SoftwareCornwall/Mission-to-Mars-Rover/Datasheets/Chassis/HTB1ze.hXRGw3KVjSZFwq6zQ2FXaO.jpg_.webp

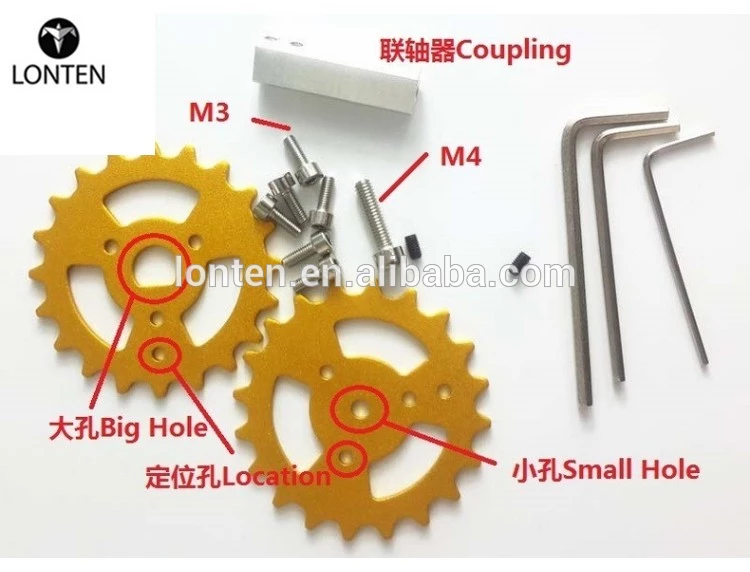
Datasheets/Chassis/HTB1ze.hXRGw3KVjSZFwq6zQ2FXaO.jpg_.webp
