SoftwareCornwall/Mission-to-Mars-Rover/Datasheets/Chassis/HTB11pEdXRWD3KVjSZFsq6AqkpXaN.jpg_.webp

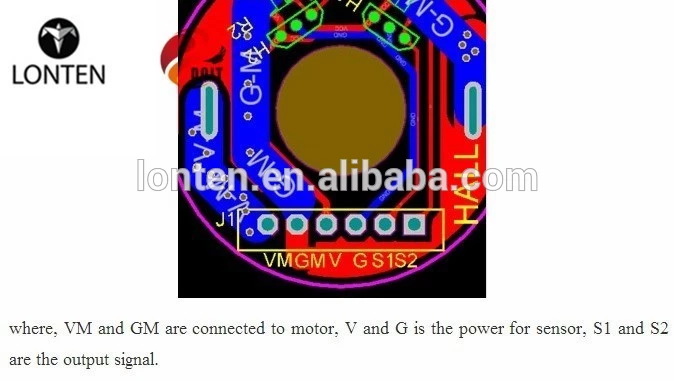
Datasheets/Chassis/HTB11pEdXRWD3KVjSZFsq6AqkpXaN.jpg_.webp
