SoftwareCornwall/Mission-to-Mars-Rover/Datasheets/Chassis/HTB1_V7cXQ9E3KVjSZFGq6A19XXaw.jpg_.webp

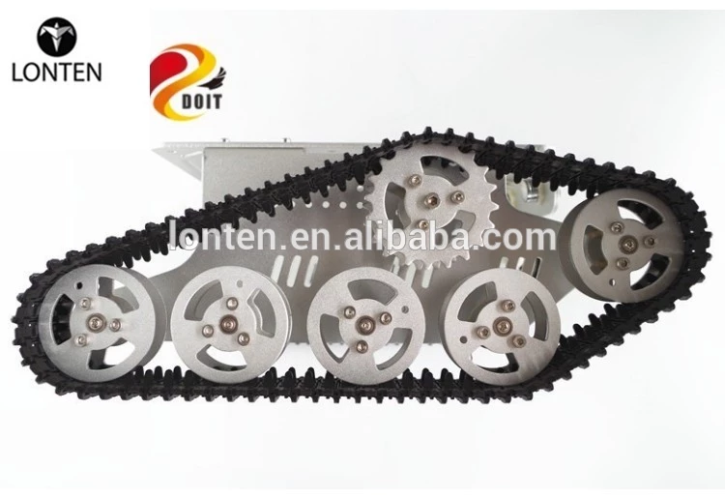
Datasheets/Chassis/HTB1_V7cXQ9E3KVjSZFGq6A19XXaw.jpg_.webp
