SoftwareCornwall/Mission-to-Mars-Rover/Datasheets/Chassis/HTB1b0IbXLWG3KVjSZPcq6zkbXXat.jpg_.webp

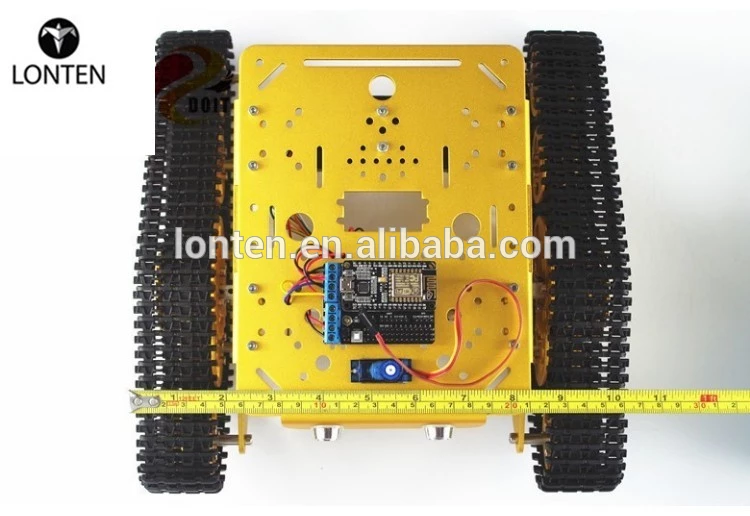
Datasheets/Chassis/HTB1b0IbXLWG3KVjSZPcq6zkbXXat.jpg_.webp
