SoftwareCornwall/Mission-to-Mars-Rover/Datasheets/Chassis/HTB1G.kcXR1D3KVjSZFyq6zuFpXam.jpg_.webp

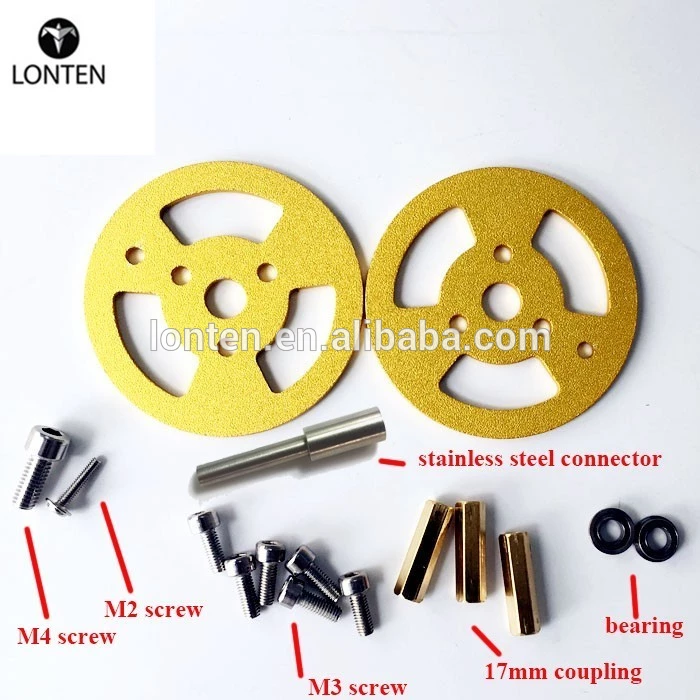
Datasheets/Chassis/HTB1G.kcXR1D3KVjSZFyq6zuFpXam.jpg_.webp
