SoftwareCornwall/Mission-to-Mars-Rover/Datasheets/Chassis/HTB1LNwaXMaH3KVjSZFpq6zhKpXaN.jpg_.webp

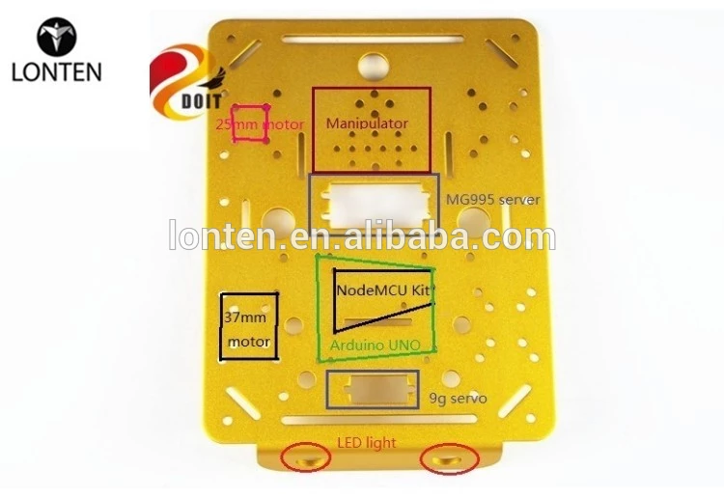
Datasheets/Chassis/HTB1LNwaXMaH3KVjSZFpq6zhKpXaN.jpg_.webp
