SoftwareCornwall/Mission-to-Mars-Rover/Datasheets/Chassis/HTB1T0UkXHus3KVjSZKbq6xqkFXaN.jpg_.webp

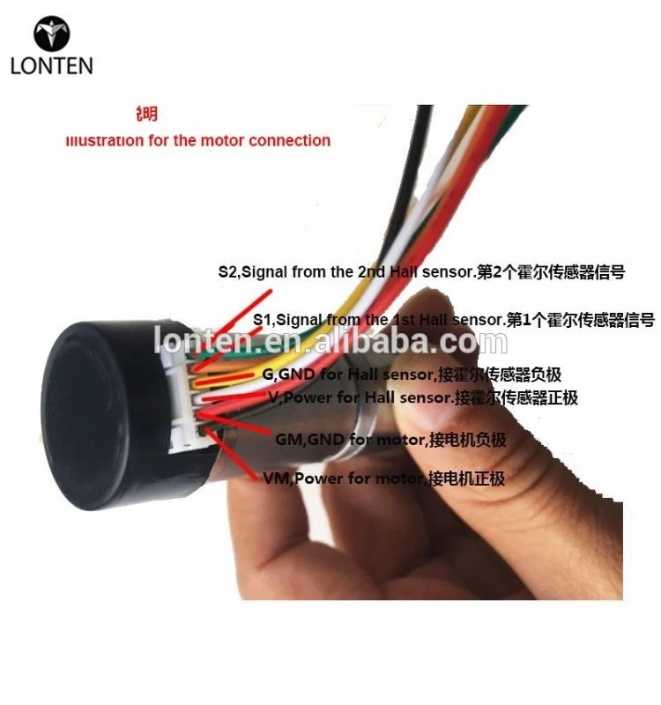
Datasheets/Chassis/HTB1T0UkXHus3KVjSZKbq6xqkFXaN.jpg_.webp
