SoftwareCornwall/Mission-to-Mars-Rover/Datasheets/Chassis/HTB1VvZbXUGF3KVjSZFmq6zqPXXaq.jpg_.webp

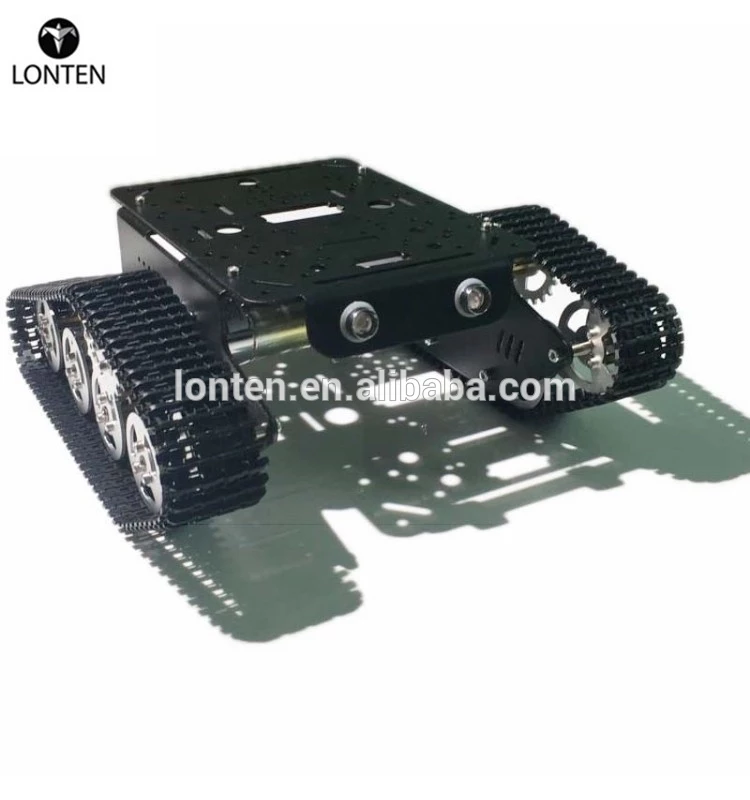
Datasheets/Chassis/HTB1VvZbXUGF3KVjSZFmq6zqPXXaq.jpg_.webp
