SoftwareCornwall/Mission-to-Mars-Rover/Handouts/Rover PCB as Breadboard_bb.png

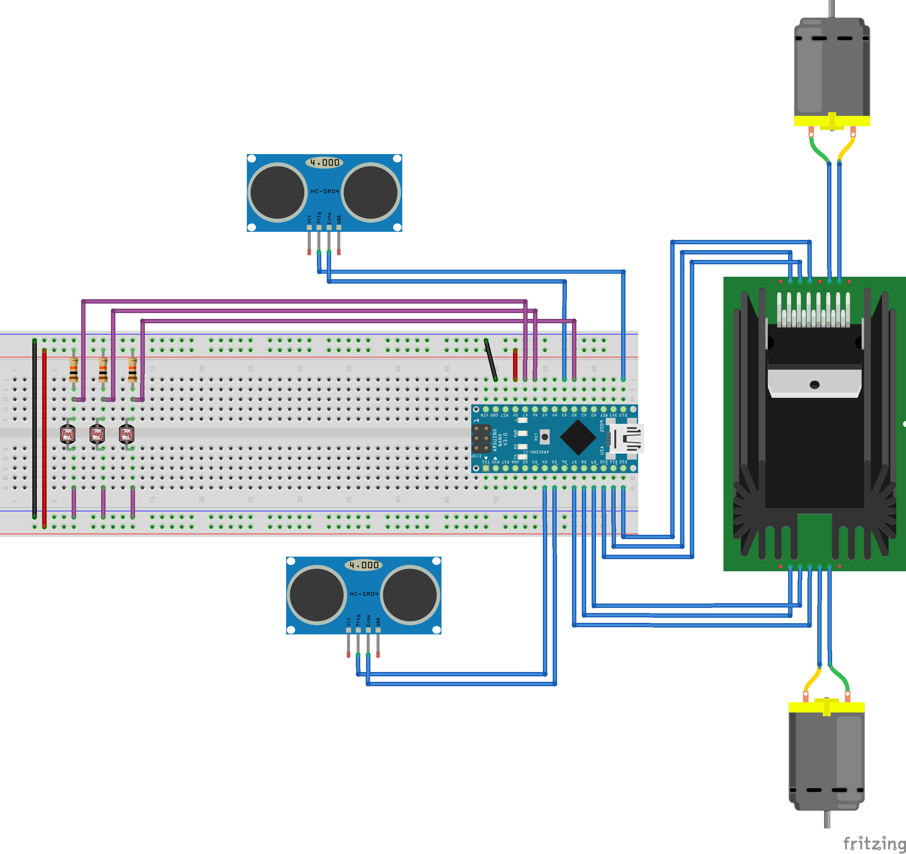
Handouts/Rover PCB as Breadboard_bb.png
