SoftwareCornwall/Mission-to-Mars-Rover/Handouts/Rover.png

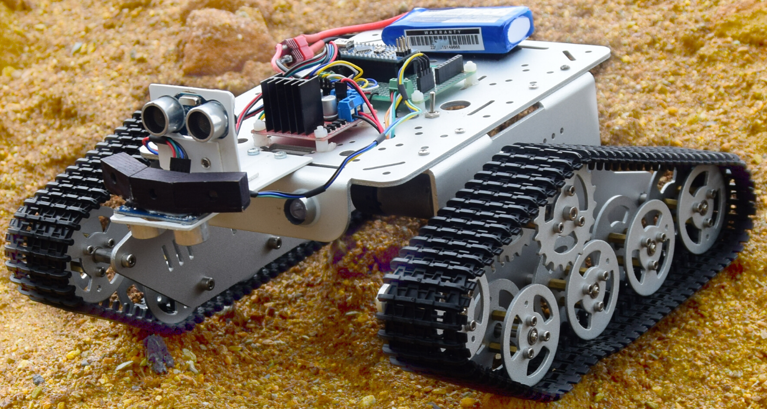
Handouts/Rover.png
