SoftwareCornwall/Mission-to-Mars-Rover/KiCad/BOM.ods

Sheet: Components
 |  |  |  |  | To Build | 10
Reference | Quantity | Value | Footprint | Other same | Multiply | Required | RS Part Number |  |  |  | Still to order
A1 | 1 | Arduino_Nano_v3.x | Module:Arduino_Nano | 1 | 2 | 20 | 1557926 |  | 20 | x | 0
BT1 | 1 | Battery | Connector_PinHeader_2.54mm:PinHeader_1x02_P2.54mm_Vertical | 3 | 1 | 10 | 7901102 | Need battery | 10 | x | 0
C2 C1 | 2 | 10pF | Capacitor_SMD:C_0805_2012Metric_Pad1.15x1.40mm_HandSolder | 3 | 1 | 20 | 2644236 |  | 25 | x | 0
C3 C4 C7 C5 | 4 | 100nF | Capacitor_SMD:C_0805_2012Metric_Pad1.15x1.40mm_HandSolder | 3 | 1 | 40 | 2644416 |  | 50 | x | 0
C8 C6 | 2 | 10uF | Capacitor_SMD:C_0805_2012Metric_Pad1.15x1.40mm_HandSolder | 3 | 1 | 20 | 6911161 |  | 20 | x | 0
D1 D3 D5 D7 D2 D4 D6 D8 | 8 | 45V, 2A | Diode_SMD:D_SOD-123 | 1 | 1 | 80 | 1528342 |  | 100 | x | 0
H1 H2 H3 H4 | 4 | MountingHole | MountingHole:MountingHole_2.7mm_Pad | 1 | 0 | 0 | - |  |  |  | 0
J1 | 1 | microbit_edge_connector | MCU_Module_Microbit:4UCON_17909_02x401.27mm_Vertical | 1 | 1 | 10 | Cool Components |  |  |  | 10
J10 | 1 | Ultrasonic Forward | Connector_PinSocket_2.54mm:PinSocket_1x04_P2.54mm_Vertical | 4 | 4 | 40 | 1548317 | ? | 40 | x | 0
J2 | 1 | Left Motor | Connector_PinSocket_2.54mm:PinSocket_1x06_P2.54mm_Vertical | 2 | 2 | 20 | 1731629 |  | 20 | x | 0
J3 | 1 | Right Motor | Connector_PinSocket_2.54mm:PinSocket_1x06_P2.54mm_Vertical | 2 | 0 | 0 | Included in 15 |  |  |  | 0
J4 | 1 | Serial (Bluetooth) | Connector_PinHeader_2.54mm:PinHeader_1x04_P2.54mm_Vertical | 1 | 1 | 10 | 2518115 |  | 25 | x | 0
J5 | 1 | MPU6050 Gyro & Acc GY-521 | Connector_PinSocket_2.54mm:PinSocket_1x08_P2.54mm_Vertical | 1 | 1 | 10 | 1800422 |  | 10 | x | 0
J6 | 1 | Compass GY-273 | Connector_PinSocket_2.54mm:PinSocket_1x04_P2.54mm_Vertical | 4 | 0 | 0 | Included in 14 |  |  |  | 0
J7 | 1 | Light Detection | Connector_PinSocket_2.54mm:PinSocket_1x04_P2.54mm_Vertical | 4 | 0 | 0 | Included in 14 |  |  |  | 0
J8 | 1 | Servo | Connector_PinHeader_2.54mm:PinHeader_1x03_P2.54mm_Vertical | 1 | 1 | 10 | 2518092 |  | 25 | x | 0
J9 | 1 | Ultrasonic Down | Connector_PinSocket_2.54mm:PinSocket_1x04_P2.54mm_Vertical | 4 | 0 | 0 | Included in 14 | ? |  |  | 0
JP1 JP2 | 2 | Jumper_2_Open | Connector_PinHeader_2.54mm:PinHeader_1x02_P2.54mm_Vertical | 3 | 1 | 20 | 8967620 |  | 50 | x | 0
R13 R14 | 2 | 1R | Resistor_SMD:R_0805_2012Metric_Pad1.15x1.40mm_HandSolder | 5 | 1 | 20 | 8123460 |  | 25 | x | 0
R15 R16 | 2 | 4.7K | Resistor_SMD:R_0805_2012Metric_Pad1.15x1.40mm_HandSolder | 5 | 1 | 20 | 8123574 |  | 25 | x | 0
R2 R1 R20 R8 R9 R10 R11 R12 R7 R5 R6 R17 R18 R19 | 14 | 10K | Resistor_SMD:R_0805_2012Metric_Pad1.15x1.40mm_HandSolder | 5 | 1 | 140 | 6790816 |  | 150 | x | 0
R3 | 1 | 1K | Resistor_SMD:R_0805_2012Metric_Pad1.15x1.40mm_HandSolder | 5 | 1 | 10 | 8123435 |  | 25 | x | 0
R4 | 1 | 2K | Resistor_SMD:R_0805_2012Metric_Pad1.15x1.40mm_HandSolder | 5 | 1 | 10 | 8123508 |  | 25 | x | 0
SW1 | 1 | SW_SPST | Connector_PinHeader_2.54mm:PinHeader_1x02_P2.54mm_Vertical | 3 | 1 | 10 | 7347117 |  | 10 | x | 0
U1 | 1 | ESP8266-ESP-01 | Connector_PinSocket_2.54mm:PinSocket_2x04_P2.54mm_Vertical | 1 | 1 | 10 | 6816836 |  | 10 | x | 0
U2 | 1 | L298HN | Package_TO_SOT_THT:TO-220-15_P2.54x2.54mm_StaggerOdd_Lead4.58mm_Vertical | 1 | 1 | 10 | 636384 (3706953) |  | 10 | x | 0
U3 | 1 | LD1117V50 | Package_TO_SOT_THT:TO-220-3_Vertical | 2 | 1 | 10 | 6869760 |  | 10 | x | 0
U4 | 1 | LD1117V33 | Package_TO_SOT_THT:TO-220-3_Vertical | 2 | 1 | 10 | 6869767 |  | 10 | x | 0
 |  |  |  | 0 | 1 | 0 |  |  |  |  | 0
PCB | 1 |  |  | 0 | 1 | 10 |  |  |  |  | 10
Arduino | 1 | https://www.amazon.co.uk/Arduino-A000005-ARDUINO-NANO/dp/B0097AU5OU |  | 0 | 1 | 10 |  |  |  |  | 10
LDRs | 3 |  |  | 0 | 1 | 30 |  |  |  |  | 30
H-Bridge Heatsink | 1 |  |  | 0 | 1 | 10 | 189-9148 |  | 10 | x | 0
 |  |  |  | 0 | 1 | 0 |  |  |  |  | 0
 |  |  |  | 0 | 1 | 0 |  |  |  |  | 0

Sheet: Non_PCB_Components
 |  |  |  |  |  | Total | 26.82
Reference | Quantity | Value | Cost | Exchange Rate | Price (ex VAT) | Min Order | Cost | Ordered
Battery | 1 |  | 19.99 for pack of 2 |  | 9.995 | 1 | 10 | 8 (4 packs)
Ultrasonic Sensors | 2 |  | 8.99 for 5 |  | 1.798 | 5 | 3.6 | 10 (2 packs)
T-Connectors | 1 |  |  |  | 0.599 |  | 0.6 | 10 (1 pack)
Power cable | 1 |  |  |  | 0.699 |  | 0.7 | 1 set
MicroBit Connector | 1 |  |  |  | 1.92 |  | 1.92
Servos | 2 |  |  |  | 5 |  | 10
 |  |  |  |  |  |  | 0

Sheet: Mechanical
 |  |  |  |  |  |  | Total | 94.3752139177228
Reference | Quantity | Value |  | Cost | Exchange Rate | Price (ex VAT) | Min Order | Cost
Tank Chasis | 1 | https://www.alibaba.com/product-detail/OEM-metal-tank-chassis-T300-t_62129242205.html |  |  |  |  |  | £88.12
 |  |  |  |  |  |  |  | 0
 |  |  |  |  |  |  |  | 0
 |  |  |  |  |  |  |  | 0
 |  |  |  |  |  |  |  | 0
 |  |  |  |  |  |  |  | 0
 |  |  |  |  |  |  |  | 0
 |  |  | 0.8218
1 | 121.06 | $121.06 | £99.49 | £99.49
2 | 222.7 | $111.35 | £91.51 | £183.01 |  |  |  | 0.919791838757641
3 | 326.82 | $108.94 | £89.53 | £268.58 |  |  |  | 0.899884354865356
4 | 431.77 | $107.94 | £88.71 | £354.83 |  |  |  | 0.891644639021973
5 | 534.4 | $106.88 | £87.83 | £439.17 |  |  |  | 0.882867999339171
6 | 640.36 | $106.73 | £87.71 | £526.25 |  |  |  | 0.881601409769261
7 | 757.7 | $108.24 | £88.95 | £622.68 |  | 2.95% Transaction fee |  | 0.894125699181044
8 | 857.82 | $107.23 | £88.12 | £704.96 |  |  |  | 0.885738476788369

Sheet: Total
 | Number |  | Individual | Total
Chassis | 8 |  | £94.38 | £755.00
Externals | 8 |  | £26.82 | £214.56
PCBs | 10 |  | £51.62 | £516.20
 |  |  |  | £0.00
 |  |  |  | £0.00
 |  |  |  | £0.00
 |  |  | Total | £1,485.76
 |  |  | Number of Rovers
 |  |  | 8
 |  |  |  |  |  |  | £0.85
 | Price
Components (RS) | £249.59 |  | External | 26.82 |  | 2 x Chassis & Shipping Price | £188.43 | Total USD | 222.71
PCBs | £27.36 |  | X 10 | 214.56 |  | Chassis | £157.00 | Chassis | 185.56 | 0.833191145435768
External components | £214.56 |  |  |  |  | Shipping | £31.44 | Shipping | 37.15 | 0.166808854564231
Chassis + shipping + taxes (x2) | £235.11 |  |  |  |  | Duty (from DHL) | £46.68
Chassis (x8) |  | £705.33
 |  |  |  |  |  | Total | £235.11
PLA | £15.00
Battery Charger | £17.99 | ordered
Battery Checker | £5.99 | ordered
 |  |  |  |  |  |  | 1.17874011569283 | $640.78 | USD | 623.04
Chassis * 6 + shipping | £508.01 |  |  |  |  |  |  | 0.7728 | Exchange rate
Taxes | 118.36 |  |  |  |  |  |  | £495.19 | GBP
 |  |  |  |  |  |  |  | £583.71 | GBP + Duty
 |  |  |  |  |  | epayments.dhl.co.uk
Total (inc VAT) | £1,391.97
Total (ex VAT) | £1,159.98 |  |  | From Nathan (to invoice) | 1600

Sheet: Number of Parts
 |  |  | Components | Number
Components | 65 | Wheel | 16 | 12 | 192
Non PCB | 8 | Motor | 5 | 2 | 10
 |  | Tracks | 1 | 2 | 2
 |  | Chassis | 19 | 1 | 19
Total | 73
 |  |  |  |  | 223
All rovers | 584 |  |  |  | 1784

Sheet: Actually_Purchases
From Nathan | £1,600.00
Left after current spend | £260.57
Left after expected spend | £108.96
Total spent | £1,339.43 |  |  |  | Total to spend | £151.61
Item | Price |  | Item | Cost per item | Required | Price
Components (RS) | £249.59 |  | PLA | £15.00 | 1 | £15.00
PCBs | £27.36 |  | Servos | £6.00 | 16 | £96.00 | (estimate)
 |  |  | LDRs | £0.91 | 24 | £21.89 | RS
Chassis + shipping + taxes (x2) | £235.11 |  |  |  |  | £0.00
Chassis * 6 + shipping | £508.01 |  |  |  |  | £0.00
Taxes | £118.36 |  |  |  |  | £0.00
 |  |  | Wire | £6.99 | 1 | £6.99 | (estimate)
Battery Charger | £17.99 | Amazon order | Switches | £1.96 | 6 | £11.74 | 710-9769 – RS individual
Battery Checker | £5.99 |  |  |  |  | £0.00
Battery | £79.96 |  |  |  |  | £0.00 | In Amazon wish list
 |  |  |  |  |  | £0.00
Ultrasonic sensors | £17.98 | Amazon order | Nuts and bolts for heat sinks |  | 8 | £0.00
T-plug connector | £5.99 |  |  |  |  | £0.00
Wire | £6.99 |  |  |  |  | £0.00
 |  |  | Arduino x 6 | £38.08 |  | £0.00 | from arduino store
micro:bit connector | £15.36 | Cool components | Arduino x 3 | £19.29 |  | £0.00
Switches | £3.91 | RS Order
15-way socket 2.54mm | £33.84 | 180-0452 – RS pack of 5 – 1.41 each
Spacer Stand offs | £12.99 | Amazon order
