SoftwareCornwall/Mission-to-Mars-Rover/(threads)

Thread 2 (2019-12-01):

T300 chassis servo hole plug

SteveAmor, 2019-12-01:
This T300 chassis servo hole plug may be useful.  I made it to stop fingers disturbing the original proto board wiring, especially when you pick the chassis up.
https://www.thingiverse.com/thing:3096444
