SoftwareCornwall/Mission-to-Mars-Rover/PDFs/Schematic.pdf

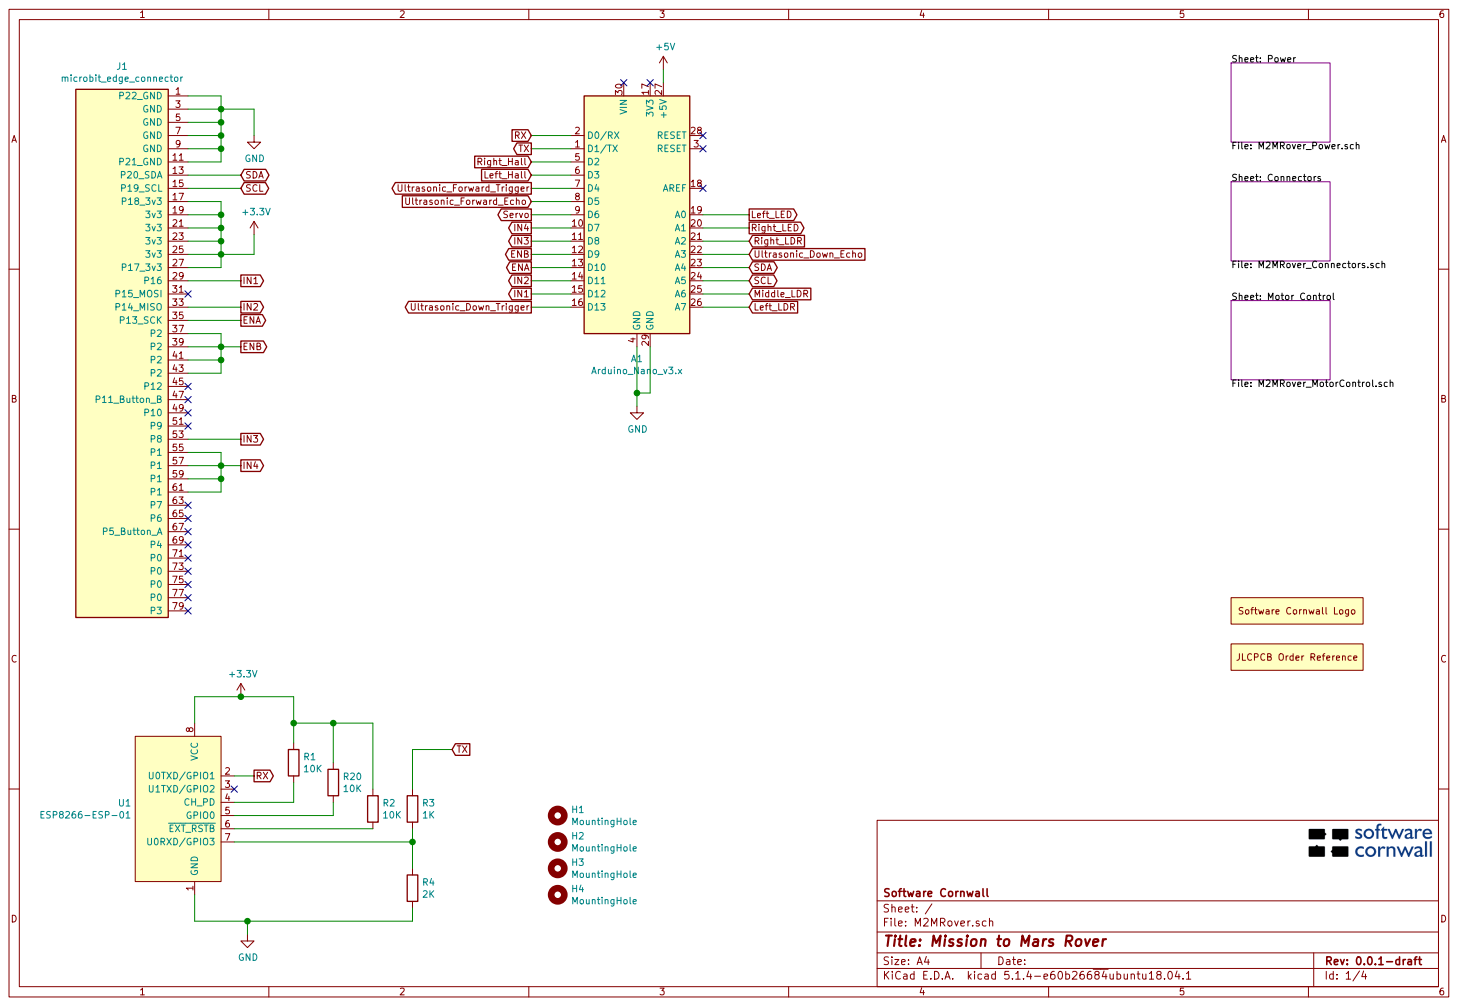
[picture p19: page 1]

Sheet: Connectors File: M2MRover_Connectors.sch Sheet: Power File: M2MRover_Power.sch Sheet: Motor Control File: M2MRover_MotorControl.sch R1

Id: 1/4 Title: Mission to Mars Rover File: M2MRover.sch Sheet: / Software Cornwall

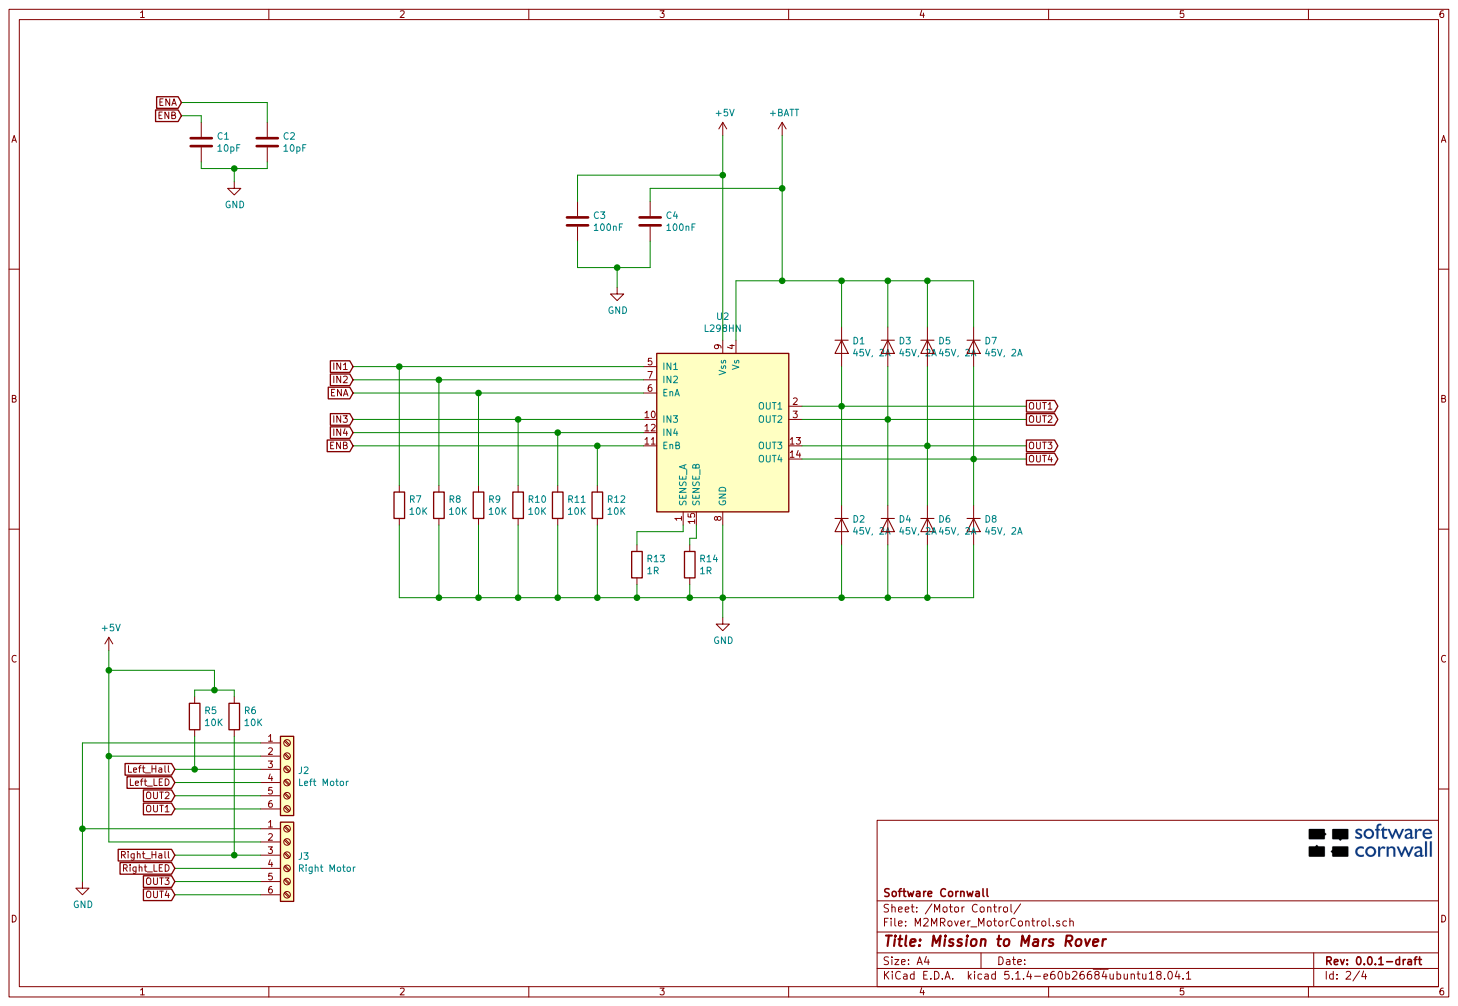
[picture p20: page 2]

Right_Hall Left_Hall Left_LED

File: M2MRover_MotorControl.sch Sheet: /Motor Control/ Software Cornwall

Id: 2/4 Title: Mission to Mars Rover

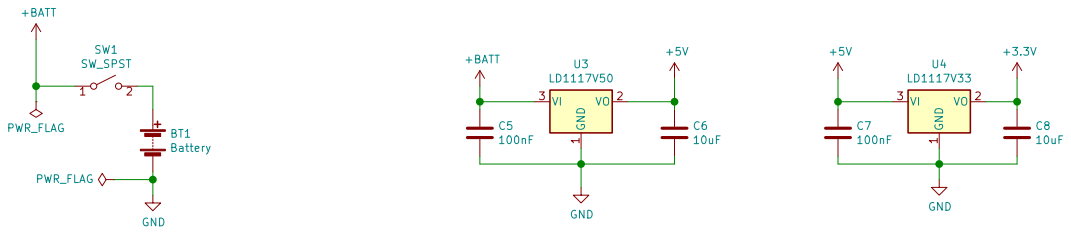
[picture p21: page 3]

File: M2MRover_Power.sch Sheet: /Power/
Id: 3/4 Title:

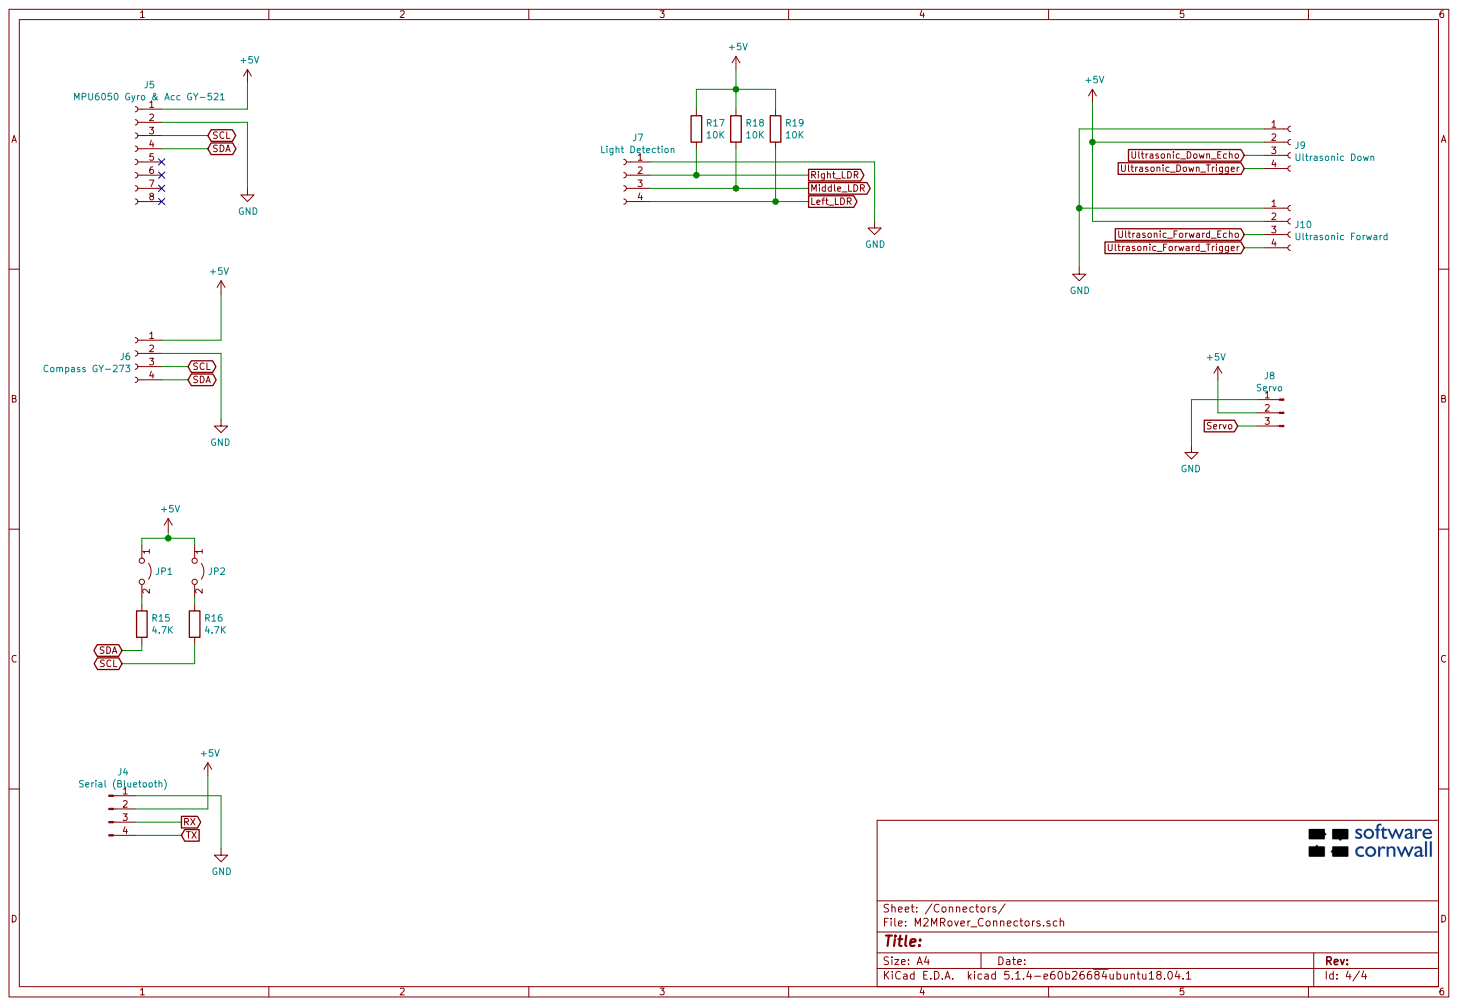
[picture p22: page 4]

File: M2MRover_Connectors.sch Sheet: /Connectors/
Id: 4/4 Title:
