SoftwareCornwall/Mission-to-Mars-Rover/PDFs/PCB.pdf

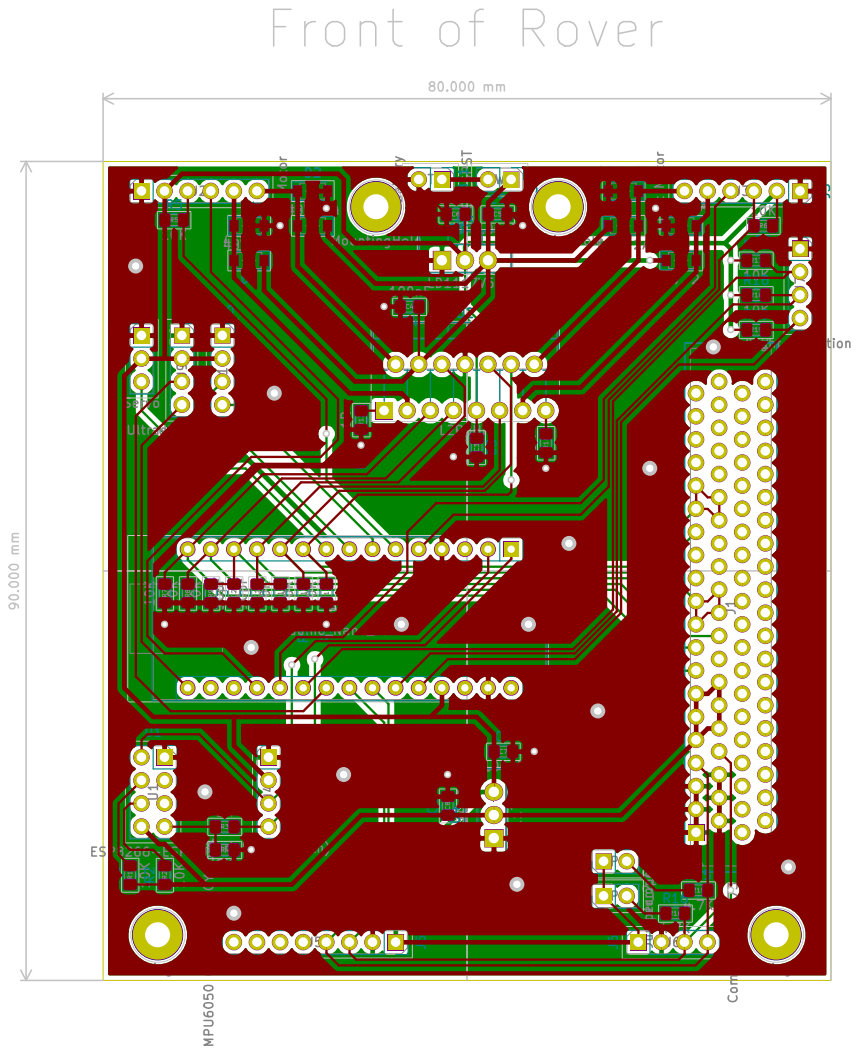
[picture p23: page 1]
