SoftwareCornwall/Mission-to-Mars-Rover/(list of files, drawings)

Other design files:
Handouts/Rover PCB as Breadboard.fzz
Handouts/Story 2 Breadboard.fzz
Handouts/Story 3 Breadboard.fzz
Handouts/Story 5 Breadboard.fzz
Handouts/Story 9 Breadboard.fzz
Handouts/Story 10 Breadboard.fzz
Handouts/Story 11 Breadboard.fzz
