SoftwareCornwall/Mission-to-Mars-Rover/KiCad/M2MRover.kicad_pcb

## KiCad design KiCad/M2MRover.kicad_pcb (2020-01-03)

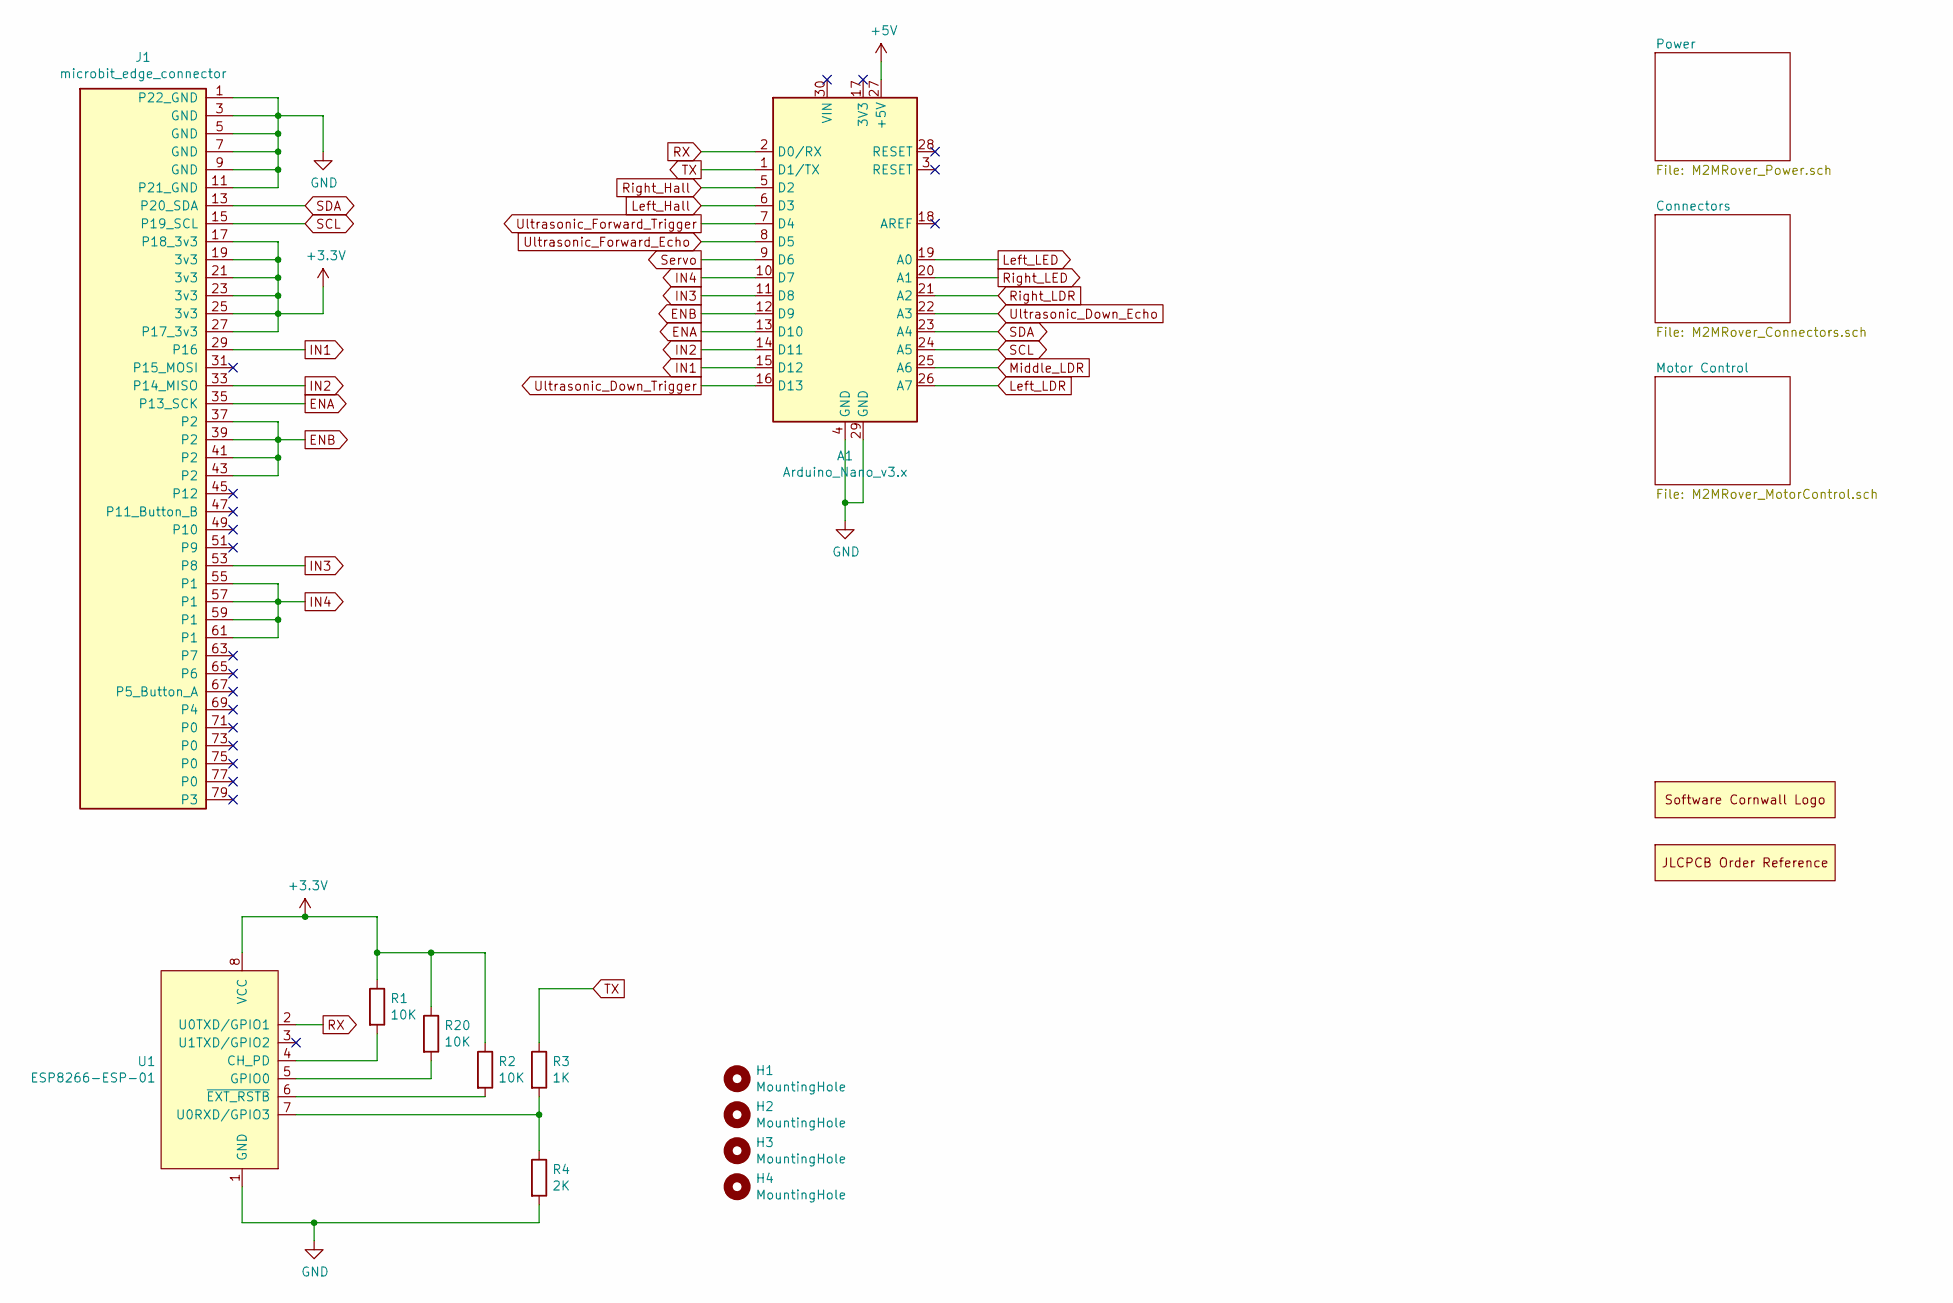
[picture p24: schematic M2MRover.sch, Mission to Mars Rover]

Parts:
A1: Arduino_Nano_v3.x; Arduino_Nano
H1, H2, H3, H4: MountingHole; MountingHole_2.7mm_Pad
J1: microbit_edge_connector; 4UCON_10156_B3_Horizontal
LOGO1: Software_Cornwall_Logo; SoftwareCornwallLogo
ORDERNO1: JLCPCB_Order_Number; JLCPCBOrderNumber
R1, R2, R20: 10K; R_0805_2012Metric_Pad1.15x1.40mm_HandSolder
R3: 1K; R_0805_2012Metric_Pad1.15x1.40mm_HandSolder
R4: 2K; R_0805_2012Metric_Pad1.15x1.40mm_HandSolder
U1: ESP8266-ESP-01; PinSocket_2x04_P2.54mm_Vertical

Connections:
+3V3: J1.17 (P18_3v3), J1.19 (3v3), J1.21 (3v3), J1.23 (3v3), J1.25 (3v3), J1.27 (P17_3v3), R1.1, R2.1, R20.1, U1.8 (VCC); also elsewhere on the board
+5V: A1.27 (+5V); also elsewhere on the board
ENA: A1.13 (D10), J1.35 (P13_SCK); also elsewhere on the board
ENB: A1.12 (D9), J1.37 (P2), J1.39 (P2), J1.41 (P2), J1.43 (P2); also elsewhere on the board
GND: A1.4 (GND), A1.29 (GND), J1.1 (P22_GND), J1.3 (GND), J1.5 (GND), J1.7 (GND), J1.9 (GND), J1.11 (P21_GND), R4.2, U1.1 (GND); also elsewhere on the board
IN1: A1.15 (D12), J1.29 (P16); also elsewhere on the board
IN2: A1.14 (D11), J1.33 (P14_MISO); also elsewhere on the board
IN3: A1.11 (D8), J1.53 (P8); also elsewhere on the board
IN4: A1.10 (D7), J1.55 (P1), J1.57 (P1), J1.59 (P1), J1.61 (P1); also elsewhere on the board
Left_Hall: A1.6 (D3); also elsewhere on the board
Left_LDR: A1.26 (A7); also elsewhere on the board
Left_LED: A1.19 (A0); also elsewhere on the board
Middle_LDR: A1.25 (A6); also elsewhere on the board
unnamed: R1.2, U1.4 (CH_PD)
unnamed: R2.2, U1.6 (~EXT_RSTB)
unnamed: R3.2, R4.1, U1.7 (U0RXD/GPIO3)
unnamed: R20.2, U1.5 (GPIO0)
RX: A1.2 (D0/RX), U1.2 (U0TXD/GPIO1); also elsewhere on the board
Right_Hall: A1.5 (D2); also elsewhere on the board
Right_LDR: A1.21 (A2); also elsewhere on the board
Right_LED: A1.20 (A1); also elsewhere on the board
SCL: A1.24 (A5), J1.15 (P19_SCL); also elsewhere on the board
SDA: A1.23 (A4), J1.13 (P20_SDA); also elsewhere on the board
Servo: A1.9 (D6); also elsewhere on the board
TX: A1.1 (D1/TX), R3.1; also elsewhere on the board
Ultrasonic_Down_Echo: A1.22 (A3); also elsewhere on the board
Ultrasonic_Down_Trigger: A1.16 (D13); also elsewhere on the board
Ultrasonic_Forward_Echo: A1.8 (D5); also elsewhere on the board
Ultrasonic_Forward_Trigger: A1.7 (D4); also elsewhere on the board

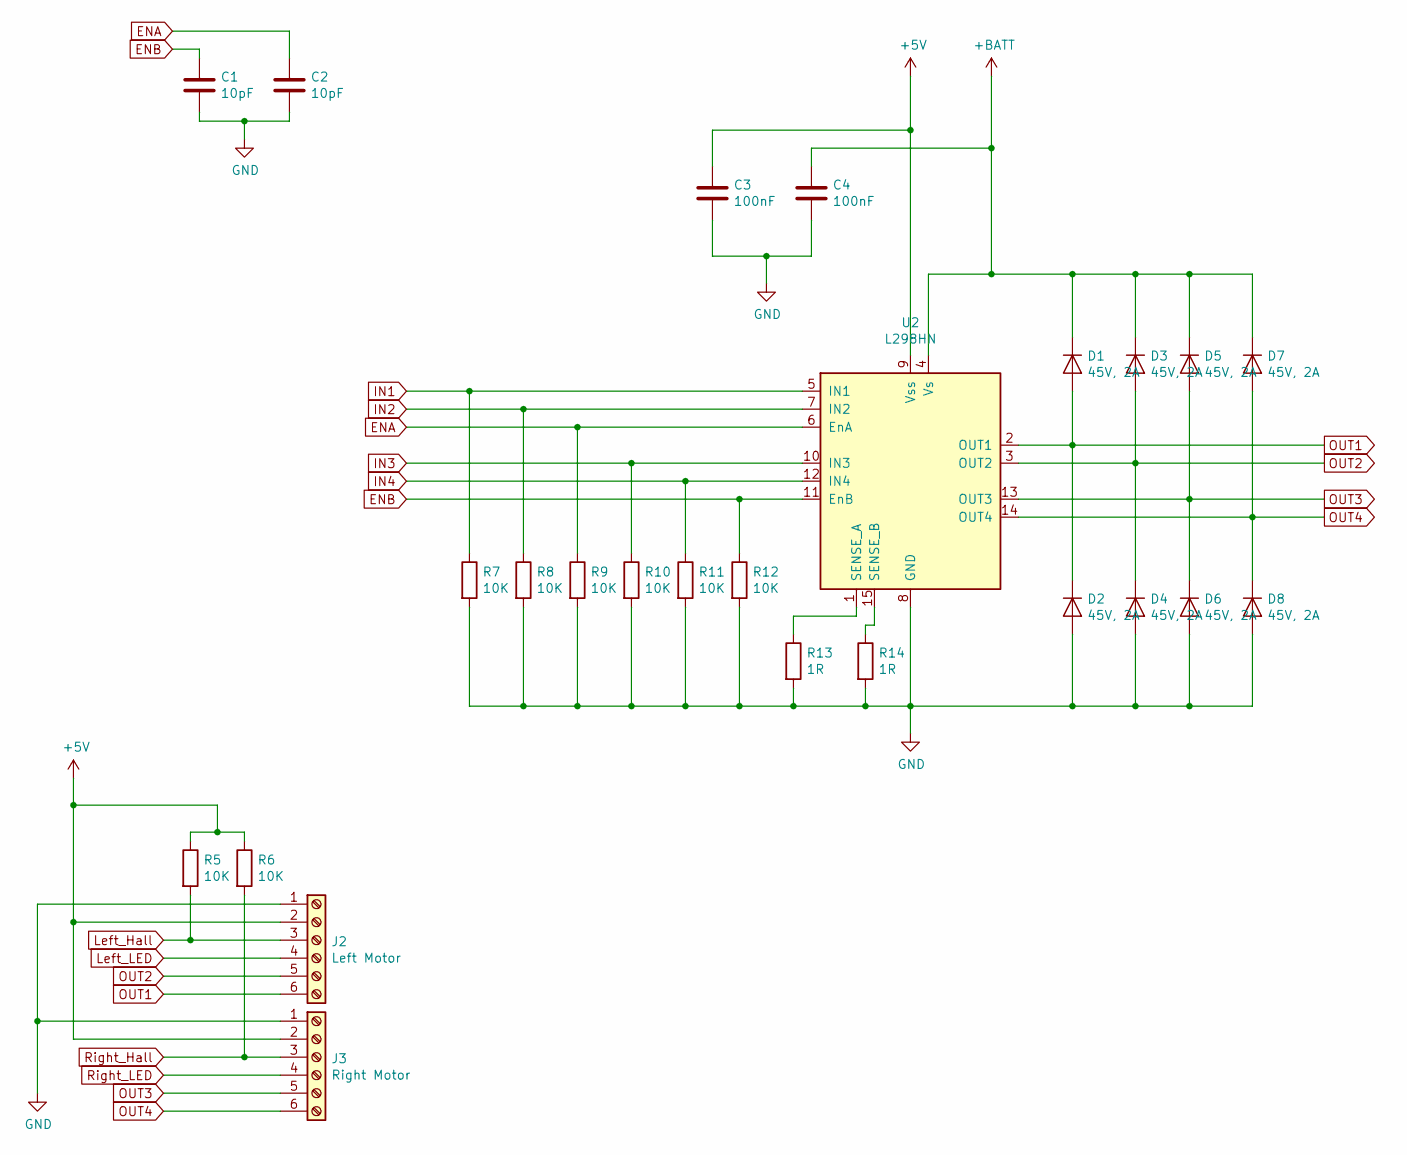
[picture p25: schematic M2MRover_MotorControl.sch, Mission to Mars Rover]

Parts:
C1, C2: 10pF; C_0805_2012Metric_Pad1.15x1.40mm_HandSolder
C3, C4: 100nF; C_0805_2012Metric_Pad1.15x1.40mm_HandSolder
D1, D2, D3, D4, D5, D6, D7, D8: 45V, 2A; D_SOD-123
J2: Left Motor; PinSocket_1x06_P2.54mm_Vertical
J3: Right Motor; PinSocket_1x06_P2.54mm_Vertical
R5, R6, R7, R8, R9, R10, R11, R12: 10K; R_0805_2012Metric_Pad1.15x1.40mm_HandSolder
R13, R14: 1R; R_0805_2012Metric_Pad1.15x1.40mm_HandSolder
U2: L298HN; TO-220-15_P2.54x2.54mm_StaggerOdd_Lead4.58mm_Vertical

Connections:
+5V: C3.1, J2.2, J3.2, R5.1, R6.1, U2.9 (Vss); also elsewhere on the board
+BATT: C4.1, D1.1 (K), D3.1 (K), D5.1 (K), D7.1 (K), U2.4 (Vs); also elsewhere on the board
ENA: C2.1, R9.1, U2.6 (EnA); also elsewhere on the board
ENB: C1.1, R12.1, U2.11 (EnB); also elsewhere on the board
GND: C1.2, C2.2, C3.2, C4.2, D2.2 (A), D4.2 (A), D6.2 (A), D8.2 (A), J2.1, J3.1, R7.2, R8.2, R9.2, R10.2, R11.2, R12.2, R13.2, R14.2, U2.8 (GND); also elsewhere on the board
IN1: R7.1, U2.5 (IN1); also elsewhere on the board
IN2: R8.1, U2.7 (IN2); also elsewhere on the board
IN3: R10.1, U2.10 (IN3); also elsewhere on the board
IN4: R11.1, U2.12 (IN4); also elsewhere on the board
Left_Hall: J2.3, R5.2; also elsewhere on the board
Left_LED: J2.4; also elsewhere on the board
unnamed: R13.1, U2.1 (SENSE_A)
unnamed: R14.1, U2.15 (SENSE_B)
OUT1: D1.2 (A), D2.1 (K), J2.6, U2.2 (OUT1)
OUT2: D3.2 (A), D4.1 (K), J2.5, U2.3 (OUT2)
OUT3: D5.2 (A), D6.1 (K), J3.5, U2.13 (OUT3)
OUT4: D7.2 (A), D8.1 (K), J3.6, U2.14 (OUT4)
Right_Hall: J3.3, R6.2; also elsewhere on the board
Right_LED: J3.4; also elsewhere on the board

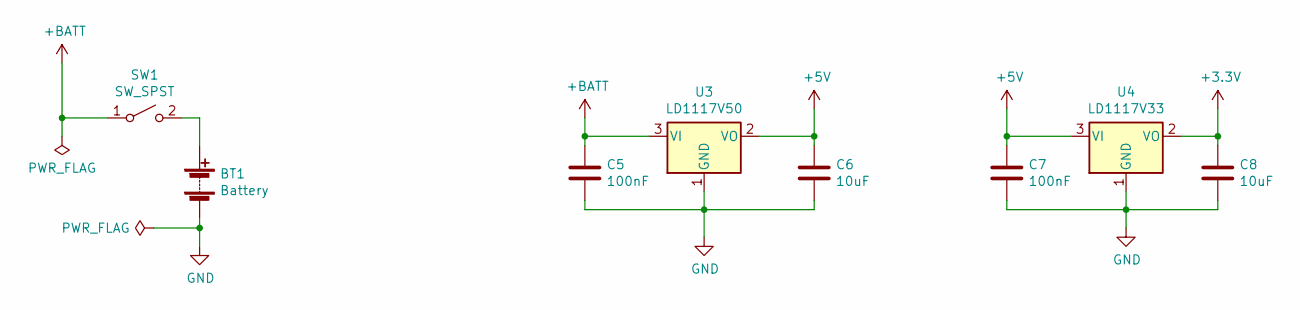
[picture p26: schematic M2MRover_Power.sch]

Parts:
BT1: Battery; PinHeader_1x02_P2.54mm_Vertical
C5, C7: 100nF; C_0805_2012Metric_Pad1.15x1.40mm_HandSolder
C6, C8: 10uF; C_0805_2012Metric_Pad1.15x1.40mm_HandSolder
SW1: SW_SPST; PinHeader_1x02_P2.54mm_Vertical
U3: LD1117V50; TO-220-3_Vertical
U4: LD1117V33; TO-220-3_Vertical

Connections:
+3V3: C8.1, U4.2 (VO); also elsewhere on the board
+5V: C6.1, C7.1, U3.2 (VO), U4.3 (VI); also elsewhere on the board
+BATT: C5.1, SW1.1 (A), U3.3 (VI); also elsewhere on the board
GND: BT1.2 (-), C5.2, C6.2, C7.2, C8.2, U3.1 (GND), U4.1 (GND); also elsewhere on the board
unnamed: BT1.1 (+), SW1.2 (B)

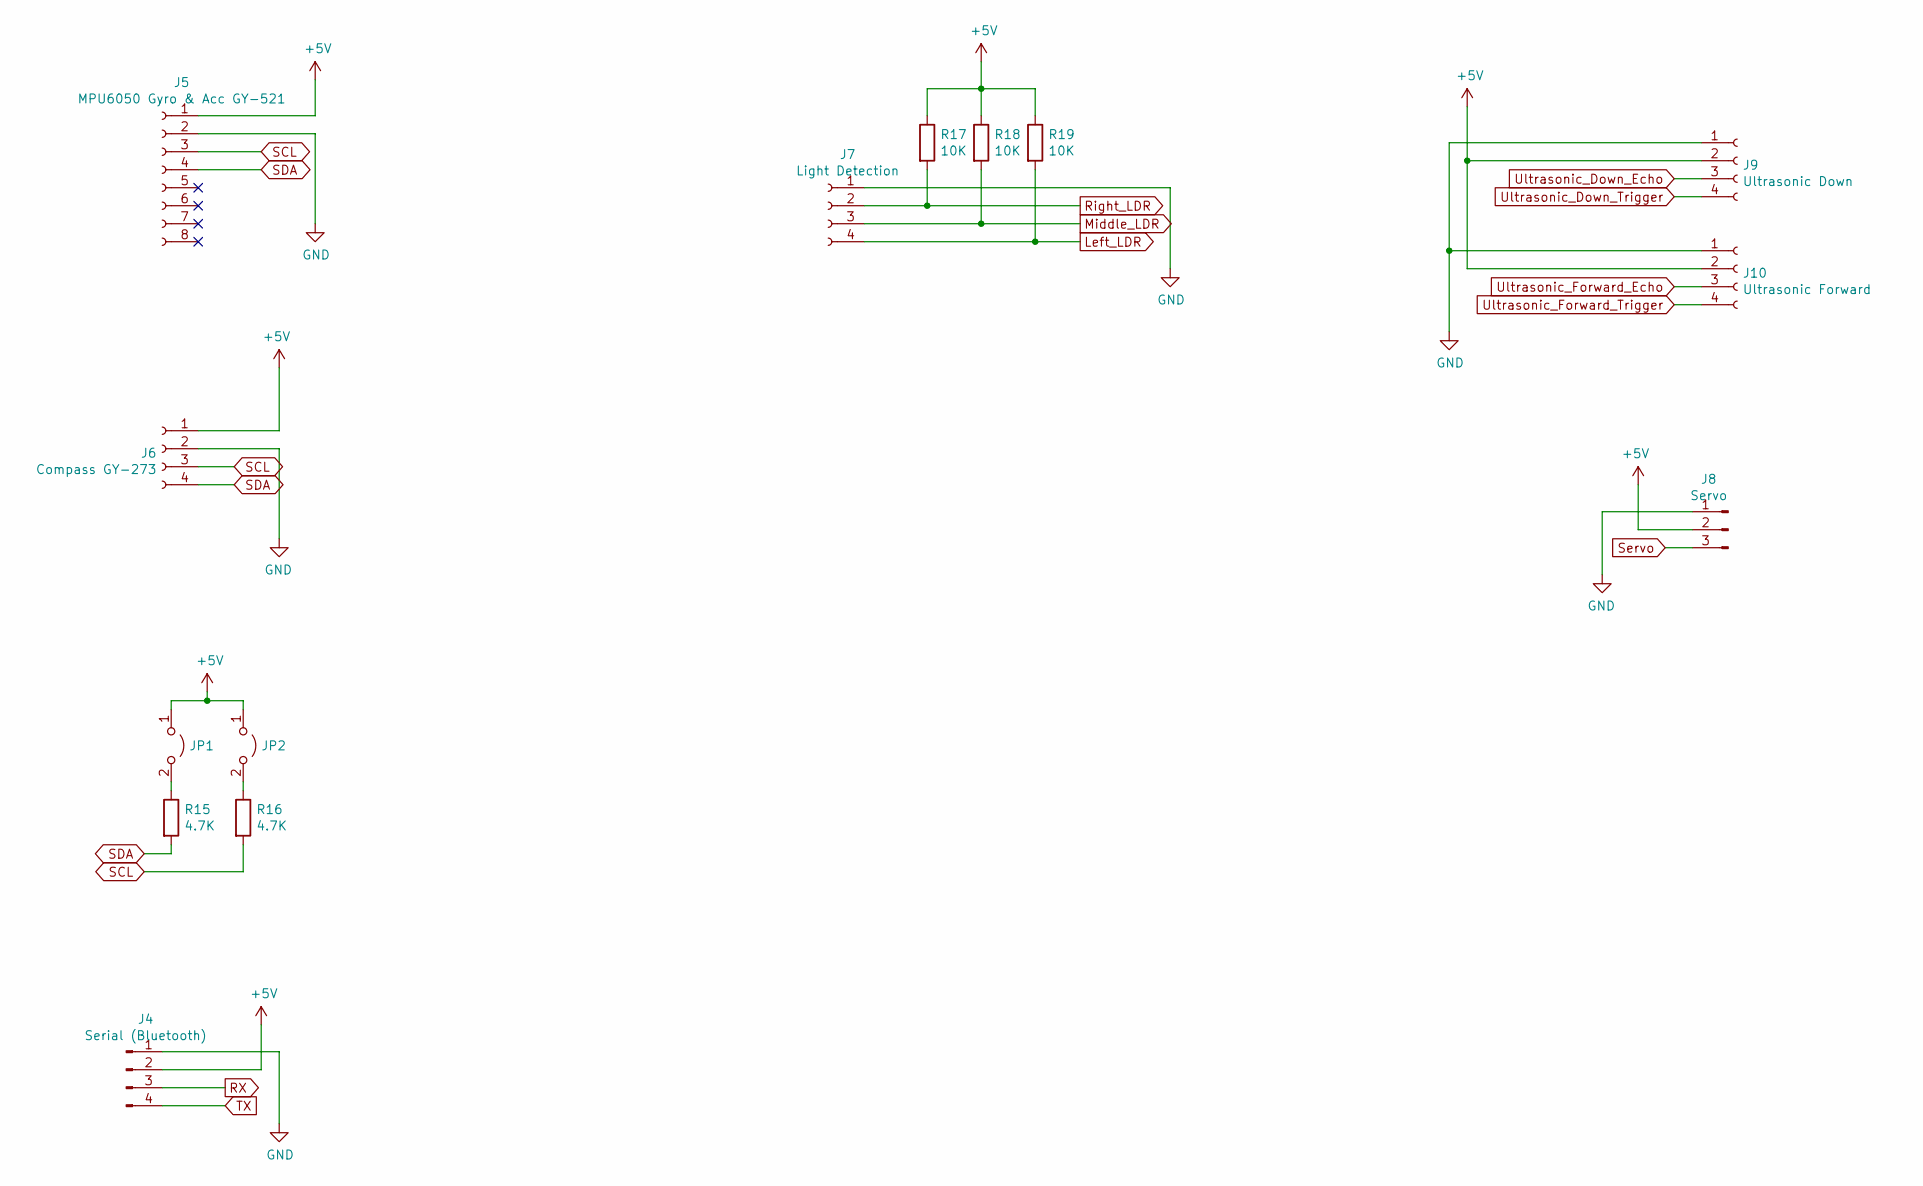
[picture p27: schematic M2MRover_Connectors.sch]

Parts:
J4: Serial (Bluetooth); PinHeader_1x04_P2.54mm_Vertical
J5: MPU6050 Gyro & Acc GY-521; PinSocket_1x08_P2.54mm_Vertical
J6: Compass GY-273; PinSocket_1x04_P2.54mm_Vertical
J7: Light Detection; PinSocket_1x04_P2.54mm_Vertical
J8: Servo; PinHeader_1x03_P2.54mm_Vertical
J9: Ultrasonic Down; PinSocket_1x04_P2.54mm_Vertical
J10: Ultrasonic Forward; PinSocket_1x04_P2.54mm_Vertical
JP1, JP2: Jumper_2_Open; PinHeader_1x02_P2.54mm_Vertical
R15, R16: 4.7K; R_0805_2012Metric_Pad1.15x1.40mm_HandSolder
R17, R18, R19: 10K; R_0805_2012Metric_Pad1.15x1.40mm_HandSolder

Connections:
+5V: J4.2, J5.1, J6.1, J8.2, J9.2, J10.2, JP1.1 (A), JP2.1 (A), R17.1, R18.1, R19.1; also elsewhere on the board
GND: J4.1, J5.2, J6.2, J7.1, J8.1, J9.1, J10.1; also elsewhere on the board
Left_LDR: J7.4, R19.2; also elsewhere on the board
Middle_LDR: J7.3, R18.2; also elsewhere on the board
unnamed: JP1.2 (B), R15.1
unnamed: JP2.2 (B), R16.1
RX: J4.3; also elsewhere on the board
Right_LDR: J7.2, R17.2; also elsewhere on the board
SCL: J5.3, J6.3, R16.2; also elsewhere on the board
SDA: J5.4, J6.4, R15.2; also elsewhere on the board
Servo: J8.3; also elsewhere on the board
TX: J4.4; also elsewhere on the board
Ultrasonic_Down_Echo: J9.3; also elsewhere on the board
Ultrasonic_Down_Trigger: J9.4; also elsewhere on the board
Ultrasonic_Forward_Echo: J10.3; also elsewhere on the board
Ultrasonic_Forward_Trigger: J10.4; also elsewhere on the board

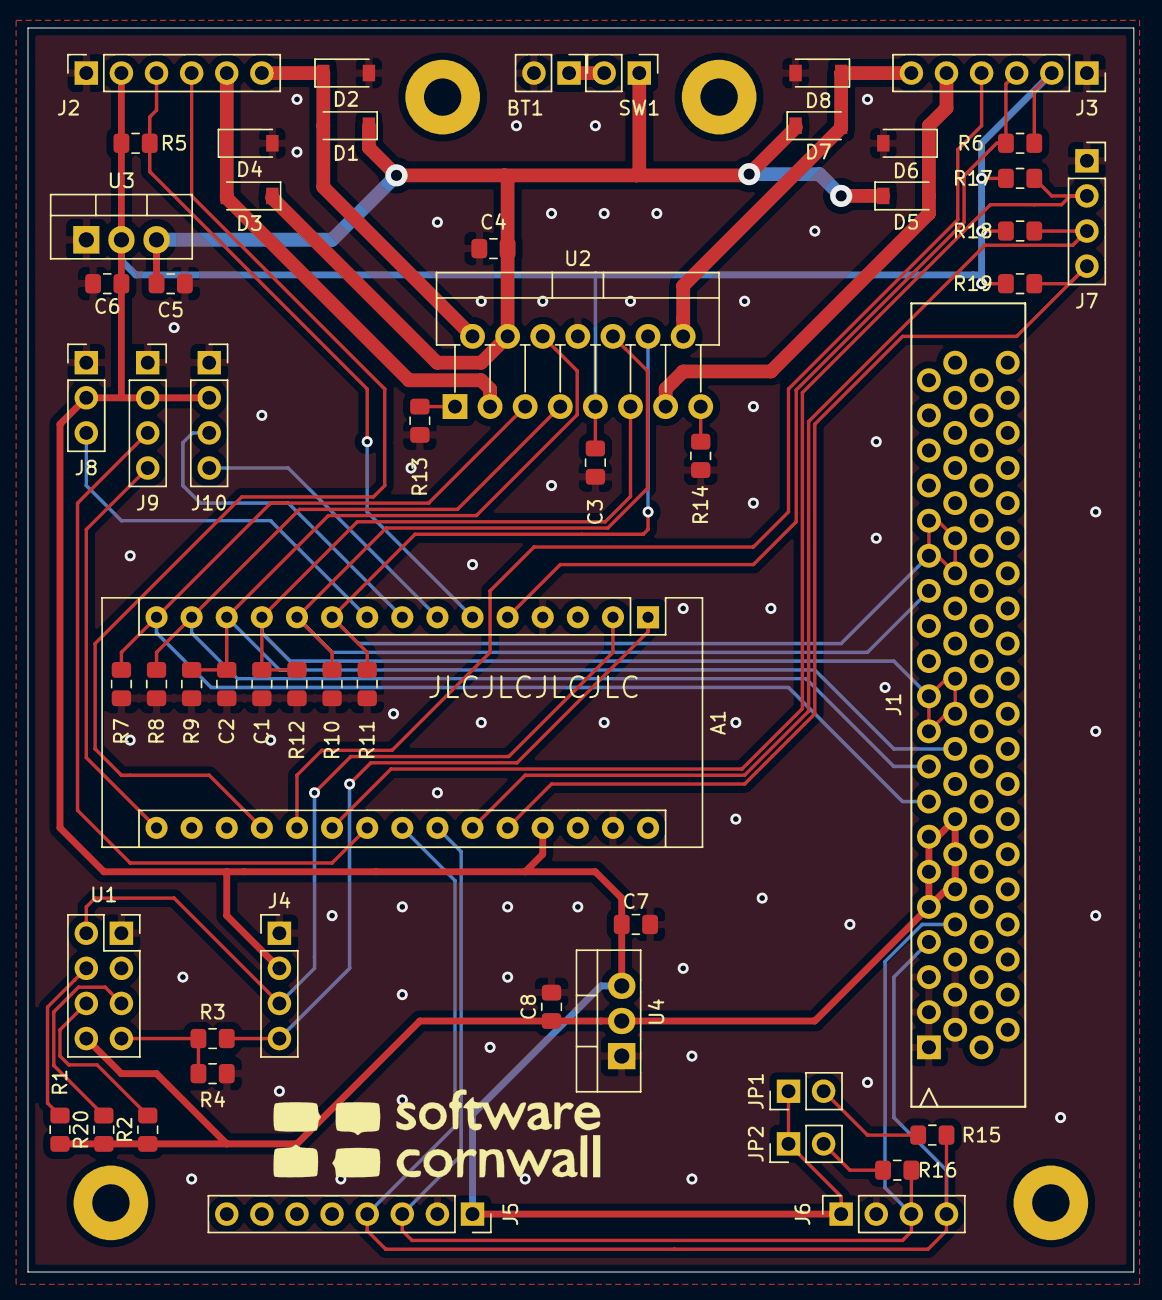
[picture p28: board M2MRover.kicad_pcb from above]

Board: 2 copper layers, 80.0 x 90.0 mm, 61 parts (0 on the bottom side), 39 nets.
