SoftwareCornwall/Mission-to-Mars-Rover/(commit log)

2019-08-23 Replace ESP8266 connector with component
    [M2MRover.sch]
2019-08-28 Add I2C pull up resistors
    [M2MRover.sch]
2019-08-28 Add capacitors to PWM output for EMC
    [M2MRover.sch]
2019-08-28 Update schematic PDF
2019-08-28 Add Software Cornwall logo to schematic
2019-08-28 Add PCB Software Cornwall logo
2019-08-30 Add initial PCB layout
    [M2MRover.kicad_pcb, M2MRover.sch]
2019-08-30 Update PDFs of Schematic and PCB
2019-09-01 Change 3.3V regulator to LD1117
    [M2MRover.kicad_pcb, M2MRover.sch]
2019-09-01 Add footprints for passive components
    [M2MRover.sch]
2019-09-01 Add passive components to PCB layout
    [M2MRover.kicad_pcb]
2019-09-05 Add jumpers to I2C lines and start PCB layout
    [M2MRover.kicad_pcb, M2MRover.sch]
2019-09-07 Add L298 component to replace separate pcb
    [M2MRover.sch, M2MRover_MotorControl.sch]
2019-09-12 Add L298N H-Bridge driver
    [M2MRover.kicad_pcb, M2MRover.sch, M2MRover_Connectors.sch, M2MRover_MotorControl.sch, M2MRover_Power.sch]
2019-09-17 Add initial BOM
    [BOM.ods]
2019-09-22 Add footprints for diodes
    [M2MRover.kicad_pcb, M2MRover_MotorControl.sch]
2019-09-22 Updated BOM
    [BOM.ods]
2019-09-22 Refactor motor wiring to h-bridge
    [M2MRover.kicad_pcb, M2MRover.sch, M2MRover_MotorControl.sch]
2019-09-23 Route the PCB
    [M2MRover.kicad_pcb, M2MRover.sch, M2MRover_MotorControl.sch, M2MRover_Power.sch]
2019-09-23 Track everything apart from LEDs and MicroBit
    [M2MRover.kicad_pcb]
2019-09-23 Track all remaining of components
    [M2MRover.kicad_pcb, M2MRover.sch]
2019-09-23 Add power plain on front side copper
    [M2MRover.kicad_pcb]
2019-09-23 Refactor some track layouts
    [M2MRover.kicad_pcb]
2019-09-23 Update PDFs with latest design
    [M2MRover.kicad_pcb]
2019-09-24 Increase H-Bridge track thickness
    [M2MRover.kicad_pcb]
2019-09-24 Add measurement for edge of MicroBit connector
    [M2MRover.kicad_pcb]
2019-09-24 Add Software Cornwall logo to silk layer
    [M2MRover.kicad_pcb]
2019-09-30 Add pull up resistor to ESP8266 GPIO0 and remove GND tracks
    [M2MRover.kicad_pcb, M2MRover.sch]
2019-09-30 Update BOM to decide how many chassis to build
    [BOM.ods]
2019-09-30 Update BOM
    [BOM.ods]
2019-09-30 Add Software Cornwall Log via symbol
    [M2MRover.kicad_pcb, M2MRover.sch]
2019-10-01 Move 5V regulator to stop physical clash
    [M2MRover.kicad_pcb]
2019-10-01 Add JLCPCB order number to silk
    [M2MRover.kicad_pcb, M2MRover.sch]
2019-10-02 Generate Gerbers
    [M2MRover.kicad_pcb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]
2019-10-03 Add Back Mask layer
    [M2MRover-B_Cu.gbr, M2MRover-B_Mask.gbr, M2MRover-Edge_Cuts.gbr, M2MRover-F_Cu.gbr, M2MRover-F_Mask.gbr, M2MRover-F_SilkS.gbr, M2MRover-NPTH.drl, M2MRover-PTH.drl]
2019-10-03 Regenerate Gerber files
    [M2MRover-B_Cu.gbr, M2MRover-B_Mask.gbr, M2MRover-Edge_Cuts.gbr, M2MRover-F_Cu.gbr, M2MRover-F_Mask.gbr, M2MRover-F_SilkS.gbr, M2MRover-NPTH.drl, M2MRover-PTH.drl]
2019-10-03 Tidy up labels on PCB Silk layer
    [M2MRover-B_Cu.gbr, M2MRover-B_Mask.gbr, M2MRover-Edge_Cuts.gbr, M2MRover-F_Cu.gbr, M2MRover-F_Mask.gbr, M2MRover-F_SilkS.gbr, M2MRover-NPTH.drl, M2MRover-PTH.drl]
2019-10-03 Add zip of Gerbers set for manufacture
2019-10-06 Update BOM with RS part numbers
    [BOM.ods]
2019-10-15 Update BOM with ordered items
    [BOM.ods]
2019-12-24 Add interactive BOM
2019-12-24 Add datasheet for Schottky Diode
2019-12-24 Add information about chassis
2019-12-24 Add latest BOM updates
    [BOM.ods]
2019-12-24 Add Arduino hardware test project
2020-01-01 Update BOM with current status of bought parts
    [BOM.ods]
2020-01-03 Add code to test servos and ultrasonic sensors
2020-01-03 Add datasheets for solder
2020-01-03 Add footprint for micro:bit connector from Cool Components
2020-01-03 Change microbit connector footprint to use new custom footprint
    [M2MRover.kicad_pcb, M2MRover.sch]
2020-01-03 Move components near J2 & J3 to allow more room for connectors
    [M2MRover.kicad_pcb]
2020-01-03 Update Gerbers
    [M2MRover-B_Cu.gbr, M2MRover-B_Mask.gbr, M2MRover-Edge_Cuts.gbr, M2MRover-F_Cu.gbr, M2MRover-F_Mask.gbr, M2MRover-F_SilkS.gbr, M2MRover-NPTH.drl, M2MRover-PTH.drl]
2020-01-05 Add zipped gerbers
2020-07-26 Add Arduino Mars Rover library
2020-07-26 Move hardware test into Arduino library
2020-07-26 Fix missing file extension on Diode datasheet
2020-07-27 Add initial iteration of handouts
    [Story 2 Breadboard.fzz, Story 3 Breadboard.fzz]
2020-07-27 Add simple circuit diagram
    [Rover PCB as Breadboard.fzz]
2020-07-28 Add Story 7 breadboard file
    [Story 2 Breadboard.fzz, Story 3 Breadboard.fzz, Story 7 Breadboard.fzz]
2020-07-28 Update the resistor values in the handouts
    [Rover PCB as Breadboard.fzz, Story 2 Breadboard.fzz, Story 3 Breadboard.fzz, Story 7 Breadboard.fzz]
2020-07-28 Correct name for Story 5 handout
    [Story 5 Breadboard.fzz]
2020-07-28 Add breadboard diagrams for stories 9, 10 & 11
    [Story 10 Breadboard.fzz, Story 11 Breadboard.fzz, Story 2 Breadboard.fzz, Story 3 Breadboard.fzz, Story 5 Breadboard.fzz, Story 9 Breadboard.fzz]
2020-07-28 Add images of Arduino Nanos to Pins page
2020-07-28 Updatte Rover Information with front page and PCB as Breadboard
    [Rover PCB as Breadboard.fzz]
2020-09-12 Add support for V1 Rovers in Arduino library
2021-06-16 Add MicroBit motors test
